TobiasNetzer/ATLabControlModule/docs/ATLabControlModule - Schematic.pdf

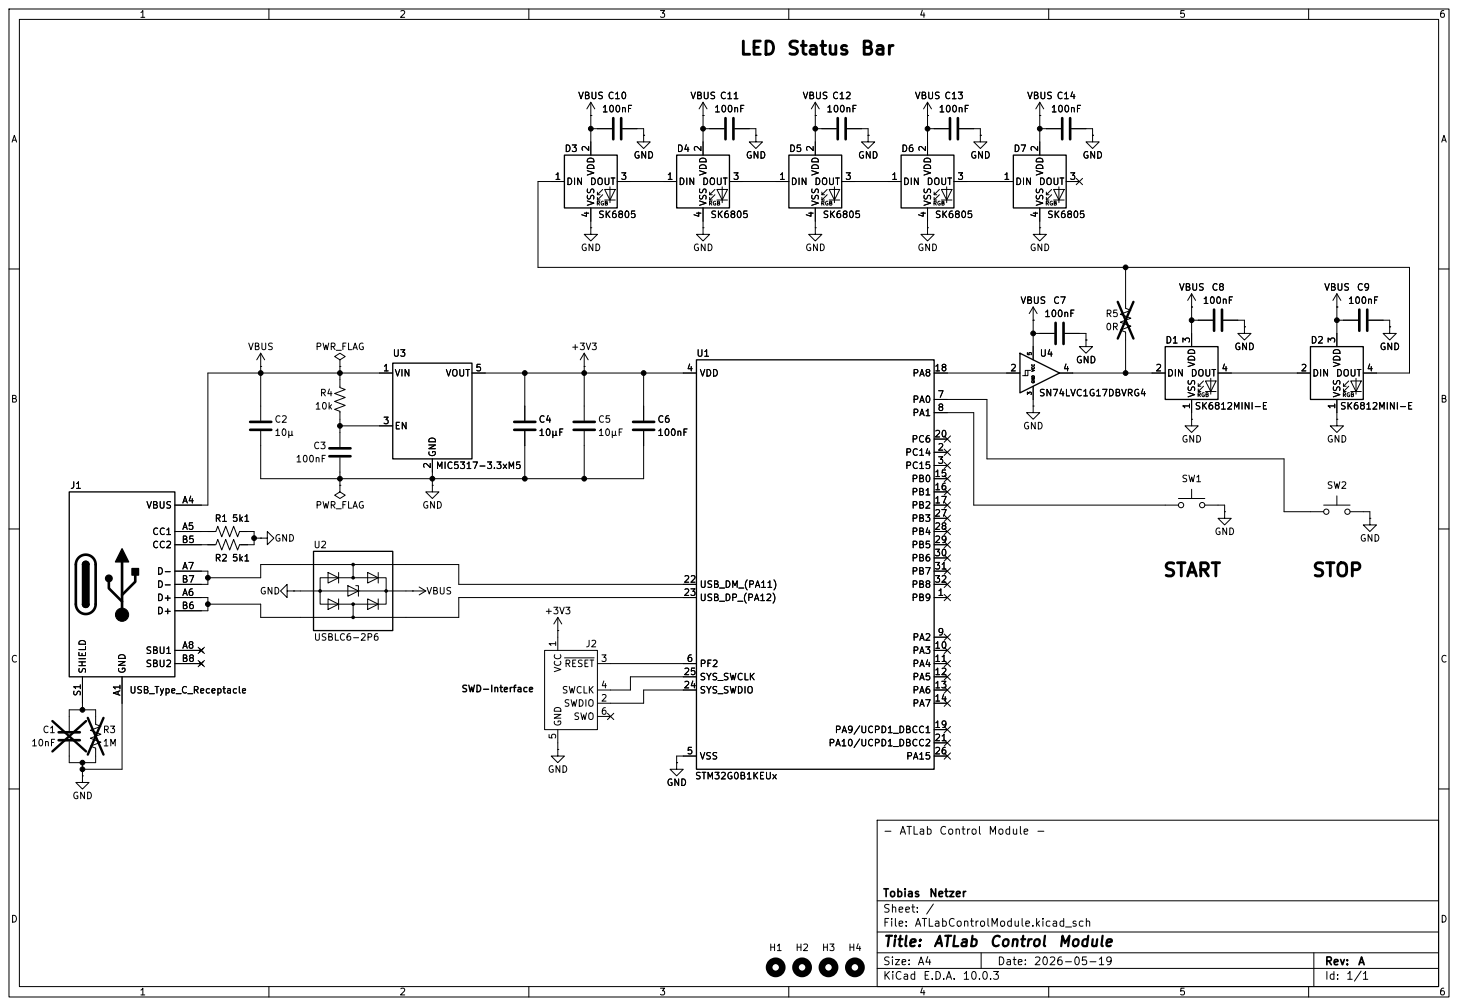
[picture p3: page 1]

Tobias Netzer - ATLab Control Module -

Sheet: /
File: ATLabControlModule.kicad_sch
Title: ATLab Control Module

Size: A4 | Rev: A
KiCad E.D.A. 10.0.3 | Id: 1/1
