TobiasNetzer/ATLabControlModule/ATLabControlModule.kicad_pcb

## KiCad design ATLabControlModule.kicad_pcb (2026-05-25)

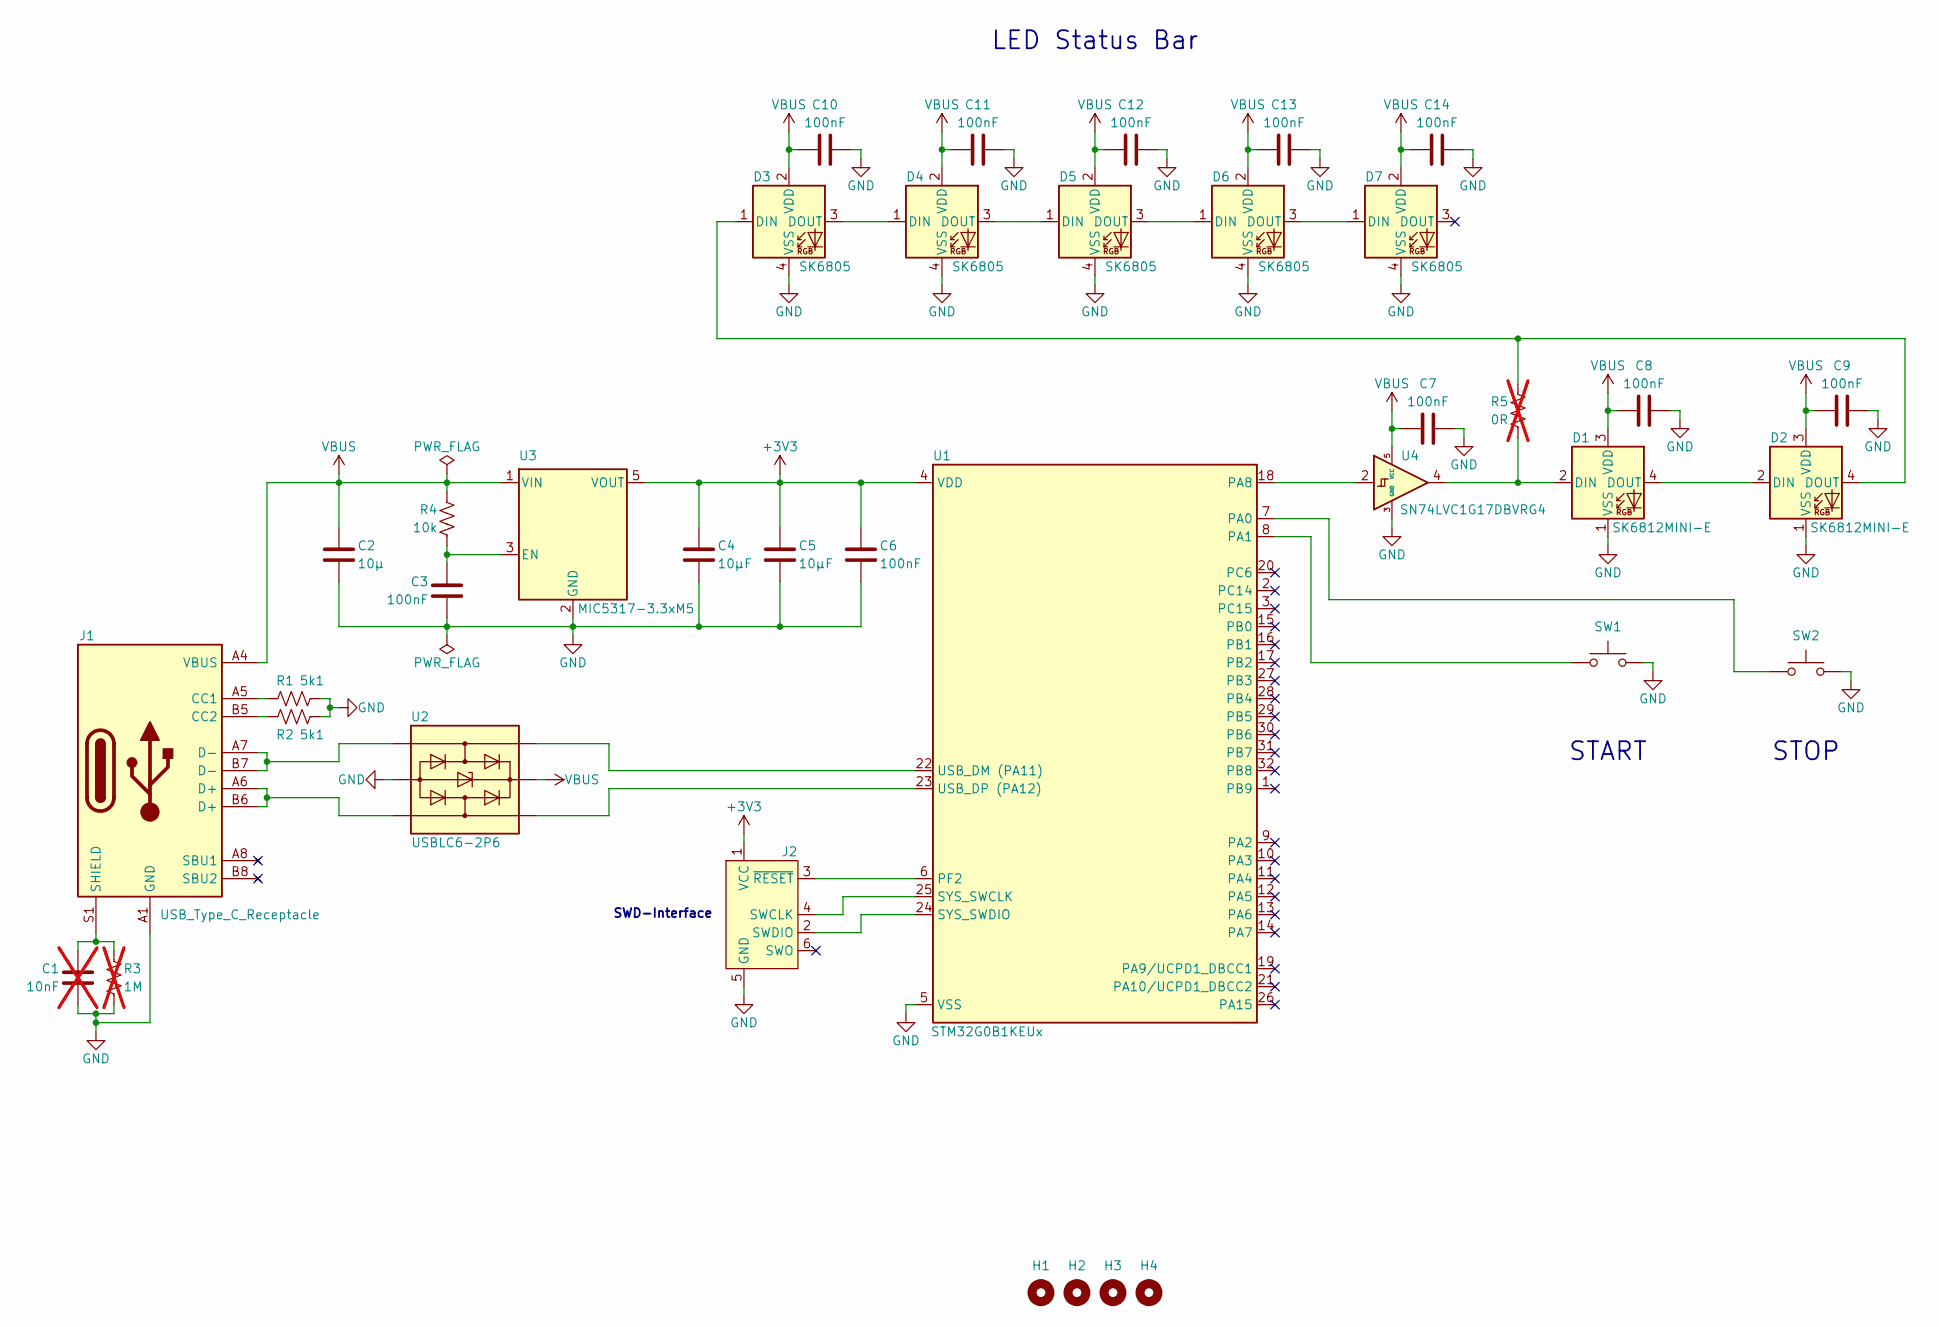
[picture p6: schematic ATLabControlModule.kicad_sch, ATLab Control Module]

Parts:
C1: 10nF; C_1206_(3216_Metric); not fitted
C2: 10µ; C_0805_(2012_Metric)
C3, C6, C7, C8, C9, C10, C11, C12, C13, C14: 100nF; C_0402_(1005_Metric)
C4, C5: 10µF; C_0805_(2012_Metric)
D1, D2: SK6812MINI-E; LED_SK6812MINI-E_3.2x2.8mm_P1.5mm_ReverseMount; Manufacturer Part Number SK6812MINI-E
D3, D4, D5, D6, D7: SK6805; LED_SK6812_EC15_1.5x1.5mm; Manufacturer Part Number SK6805-EC15
H1, H2, H3, H4: MountingHole; Mounting_Hole
J1: USB_Type_C_Receptacle; USB_C_Receptacle_HRO_TYPE-C-31-M-12; Manufacturer Part Number USB_C_Receptacle_HRO_TYPE-C-31-M-12
J2: Conn_ARM_SWD_TagConnect_TC2030; Tag-Connect_TC2030-IDC-NL_2x03_P1.27mm_Vertical
R1, R2: 5k1; R_0402_(1005_Metric)
R3: 1M; R_1206_(3216_Metric); not fitted
R4: 10k; R_0402_(1005_Metric)
R5: 0R; R_0402_(1005_Metric); not fitted
SW1, SW2: Kailh_Choc_V2_Brown; SW_Kailh_Choc_V2; Manufacturer Part Number CPG135301D02
U1: STM32G0B1KEUx; QFN-32-1EP_5x5mm_P0.5mm_EP3.45x3.45mm; Manufacturer Part Number STM32G0B1KEU6
U2: USBLC6-2P6; SOT-666; Manufacturer Part Number USBLC6-2P6
U3: MIC5317-3.3xM5; SOT-23-5; Manufacturer Part Number MIC5317-3.3YM5-TR
U4: SN74LVC1G17DBVRG4; SOT-23-5; Manufacturer Part Number SN74LVC1G17DBVRG4

Connections:
+3V3: C4.1, C5.1, C6.1, J2.1 (VCC), U1.4 (VDD), U3.5 (VOUT)
GND: C1.2, C2.2, C3.2, C4.2, C5.2, C6.2, C7.2, C8.2, C9.2, C10.2, C11.2, C12.2, C13.2, C14.2, D1.1 (VSS), D2.1 (VSS), D3.4 (VSS), D4.4 (VSS), D5.4 (VSS), D6.4 (VSS), D7.4 (VSS), J1.A1 (GND), J1.A12 (GND), J1.B1 (GND), J1.B12 (GND), J2.5 (GND), R1.2, R2.2, R3.2, SW1.2, SW2.2, U1.5 (VSS), U1.33 (VSS), U2.2 (GND), U3.2 (GND), U4.3 (GND)
unnamed: D1.2 (DIN), R5.2, U4.4
unnamed: D1.4 (DOUT), D2.2 (DIN)
unnamed: D2.4 (DOUT), D3.1 (DIN), R5.1
unnamed: D3.3 (DOUT), D4.1 (DIN)
unnamed: D4.3 (DOUT), D5.1 (DIN)
unnamed: D5.3 (DOUT), D6.1 (DIN)
unnamed: D6.3 (DOUT), D7.1 (DIN)
unnamed: J1.A5 (CC1), R1.1
unnamed: J1.B5 (CC2), R2.1
unnamed: J1.A6 (D+), J1.B6 (D+), U2.3 (I/O2)
unnamed: J1.A7 (D-), J1.B7 (D-), U2.1 (I/O1)
unnamed: C1.1, J1.S1 (SHIELD), R3.1
unnamed: J2.4 (SWCLK), U1.25 (SYS_SWCLK)
unnamed: J2.2 (SWDIO), U1.24 (SYS_SWDIO)
unnamed: J2.3 (~RESET), U1.6 (PF2)
unnamed: SW2.1, U1.7 (PA0)
unnamed: SW1.1, U1.8 (PA1)
unnamed: U1.18 (PA8), U4.2
unnamed: U1.22 (USB_DM (PA11)), U2.6 (I/O1)
unnamed: U1.23 (USB_DP (PA12)), U2.4 (I/O2)
unnamed: C3.1, R4.2, U3.3 (EN)
VBUS: C2.1, C7.1, C8.1, C9.1, C10.1, C11.1, C12.1, C13.1, C14.1, D1.3 (VDD), D2.3 (VDD), D3.2 (VDD), D4.2 (VDD), D5.2 (VDD), D6.2 (VDD), D7.2 (VDD), J1.A4 (VBUS), J1.A9 (VBUS), J1.B4 (VBUS), J1.B9 (VBUS), R4.1, U2.5 (VBUS), U3.1 (VIN), U4.5 (VCC)

Notes on the sheet:
START
STOP
SWD-Interface
LED Status Bar

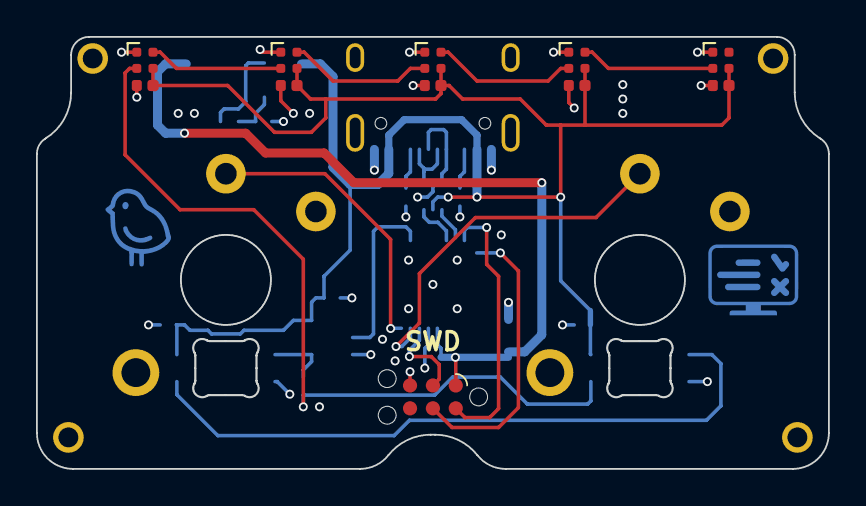
[picture p7: board ATLabControlModule.kicad_pcb from above]

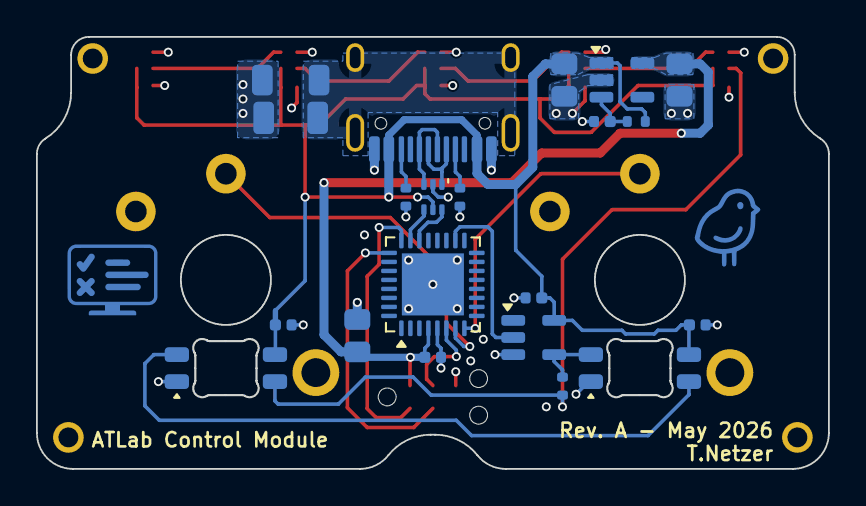
[picture p8: board ATLabControlModule.kicad_pcb from below]

Board: 4 copper layers, 44.0 x 24.0 mm, 38 parts (21 on the bottom side), 24 nets.
