TobiasNetzer/ATLabControlModule/docs/Render_Assembly_bot.png

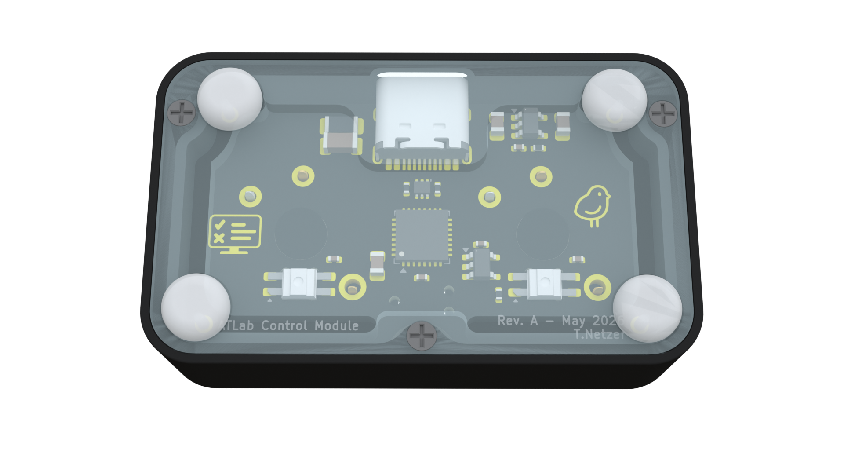
docs/Render_Assembly_bot.png
