TobiasNetzer/ATLabControlModule/(commit log)

2026-05-17 Imported symbols and footprints to local library
    [ATLabControlModule.kicad_pcb, ATLabControlModule.kicad_sch]
2026-05-18 update library and schematic
    [ATLabControlModule.kicad_sch]
2026-05-19 schematic rev A
    [ATLabControlModule.kicad_sch]
2026-05-24 PCB Rev A
    [ATLabControlModule.kicad_pcb, ATLabControlModule.kicad_sch]
2026-05-25 cleanup and add docs
    [ATLabControlModule.kicad_pcb, ATLabControlModule.kicad_sch]
